tgenovese/hailfire-eagle/projects/ADC33/ADC33-parts.xls

NOM | DESCRIPTION | CODE FARNELL | QUANTITE
MICROCHIP MCP3008-I/SL | 10BIT ADC, 8 CH, SPI, SMD, SOIC16 | 1292241 | 1
TI REF2933AIDBZT | IC, SM, VOLT REF, 3.3V | 1459250 | 1
KEMET C0805C105K4RAC | CONDENSATEUR 0805 1UF 16V | 9227792 | 2
KEMET C0805C104K5RAC | CONDENSATEUR 100NF 50V X7R 0805 | 1414664 | 9
HARTING 0918 510 7323 | EMBASE HE10 COUDEE 10 VOIES | 1096980 | 1
AMP 5-825437-0 | BARRETTE COUDEE 1 RANGEE 50 VOIES 2.54MM | 3417931 | 1
IMO 21.155MH/3 | EMBASE COUDEE 3 VOIES | 9632905 | 1
IMO 21.1550M/3 | FICHE MALE LIBRE 3 VOIES | 9632743 | 1
