tgenovese/hailfire-eagle/projects/AlimBoard/AlimBoard-parts.xls

NOM | DESCRIPTION | CODE FARNELL | QUANTITE
TRACOPOWER TEN 20-2411WIN | CONVERTISSEUR DC/DC 20W 5V/4A | 1284266 | 1
TRACOPOWER TEN 15-2410WI | CONVERTISSEUR DC/DC 15W 3.3V/3A | 1007485 | 1
CAMDEN ELECTRONICS CTB9350/2A | EMBASE COUDEE 2 VOIES | 3882093 | 3
CAMDEN ELECTRONICS CTB9200/2A | BORNIER ENFICHABLE 2 VOIES | 3881854 | 3
IMO 21.155MH/3 | EMBASE COUDEE 3 VOIES | 9632905 | 3
IMO 21.1550M/3 | FICHE MALE LIBRE 3 VOIES | 9632743 | 3
