tgenovese/hailfire-eagle/projects/PWM50/PWM50-parts.xls

NOM | DESCRIPTION | CODE FARNELL | QUANTITE
AVAGO HCPL-0630-000E | OPTOCOUPLEUR CMS DOUBLE SORTIE LOGIQUE | 359993 | 4
KOA SG73S2ATTD2000F | RESISTANCE 200 OHM 1% 0805 | 1400301 | 8
KOA SG73S2ATTD3900F | RESISTANCE 390 OHM 1% 0805 | 1400309 | 8
KEMET C0805C104K5RAC | CONDENSATEUR 100NF 50V X7R 0805 | 1414664 | 12
HARTING 0918 510 7323 | EMBASE HE10 COUDEE 10 VOIES | 1096980 | 1
AMP 5-825437-0 | BARRETTE COUDEE 1 RANGEE 50 VOIES 2.54MM | 3417931 | 1
IMO 21.155MH/3 | EMBASE COUDEE 3 VOIES | 9632905 | 1
IMO 21.1550M/3 | FICHE MALE LIBRE 3 VOIES | 9632743 | 1
