tgenovese/hailfire-eagle/projects/MainStack/StackOverflow/StackOverflow-parts.xls

NOM | DESCRIPTION | CODE FARNELL | QUANTITE
AMP 5-826632-0 | BARRETTE DROITE 2 RANGEES 100V 2.54MM | 3418560 | 2
HARTING 0918 510 7324 | EMBASE HE10 DROITE 10 VOIES | 1096985 | 14
