tgenovese/hailfire-eagle/projects/MainStack/StackUnderflow/StackUnderflow-parts.xls

NOM | DESCRIPTION | CODE FARNELL | QUANTITE
HARWIN M20F6113205 | CONNECTEUR PC104 64 VOIES | 359993 | 2
AMP 5-825437-0 | BARRETTE COUDEE 1 RANGEE 50 VOIES 2.54MM | 3417931 | 1
AMP 5-826634-0 | BARRETTE COUDEE 2 RANGEES 100 VOIES 2.54MM | 3418650 | 1
IMO 21.155MH/3 | EMBASE COUDEE 3 VOIES | 9632905 | 1
IMO 21.1550M/3 | FICHE MALE LIBRE 3 VOIES | 9632743 | 1
KEMET C0805C105K4RAC | CONDENSATEUR 0805 1UF 16V | 9227792 | 2
KEMET C0805C104K5RAC | CONDENSATEUR 100NF 50V X7R 0805 | 1414664 | 4
MAXIM MAX3390 | LOGIC LEVEL CONVERTER | sample | 1
MAXIM MAX3391 | LOGIC LEVEL CONVERTER | sample | 1
KPS-1280 | SWITCH CMS COUDE | SparkFun: 8769
