tgenovese/hailfire-eagle/projects/Attic/SandwichBoard/SandwichBoard-parts.xls

NOM | DESCRIPTION | CODE FARNELL | QUANTITE
AMP 5-826632-0 | BARRETTE DROITE 2 RANGEES 100V 2.54MM | 3418560 | 2
AMP 5-825437-0 | BARRETTE COUDEE 1 RANGEE 50 VOIES 2.54MM | 3417931 | 1
HARWIN M20F6112005 | CONNECTEUR PC104 40 VOIES | 359970 | 1
KEMET C0805C105K4RAC | CONDENSATEUR 0805 1UF 16V | 9227792 | 3
KEMET C0805C104K5RAC | CONDENSATEUR 100NF 50V X7R 0805 | 1414664 | 6
MAXIM MAX3390 | LOGIC LEVEL CONVERTER | sample | 1
MAXIM MAX3391 | LOGIC LEVEL CONVERTER | sample | 2
