tgenovese/hailfire-eagle/projects/Dumb-E/Dumb-E.brd

## EAGLE design projects/Dumb-E/Dumb-E.brd (2016-03-28)

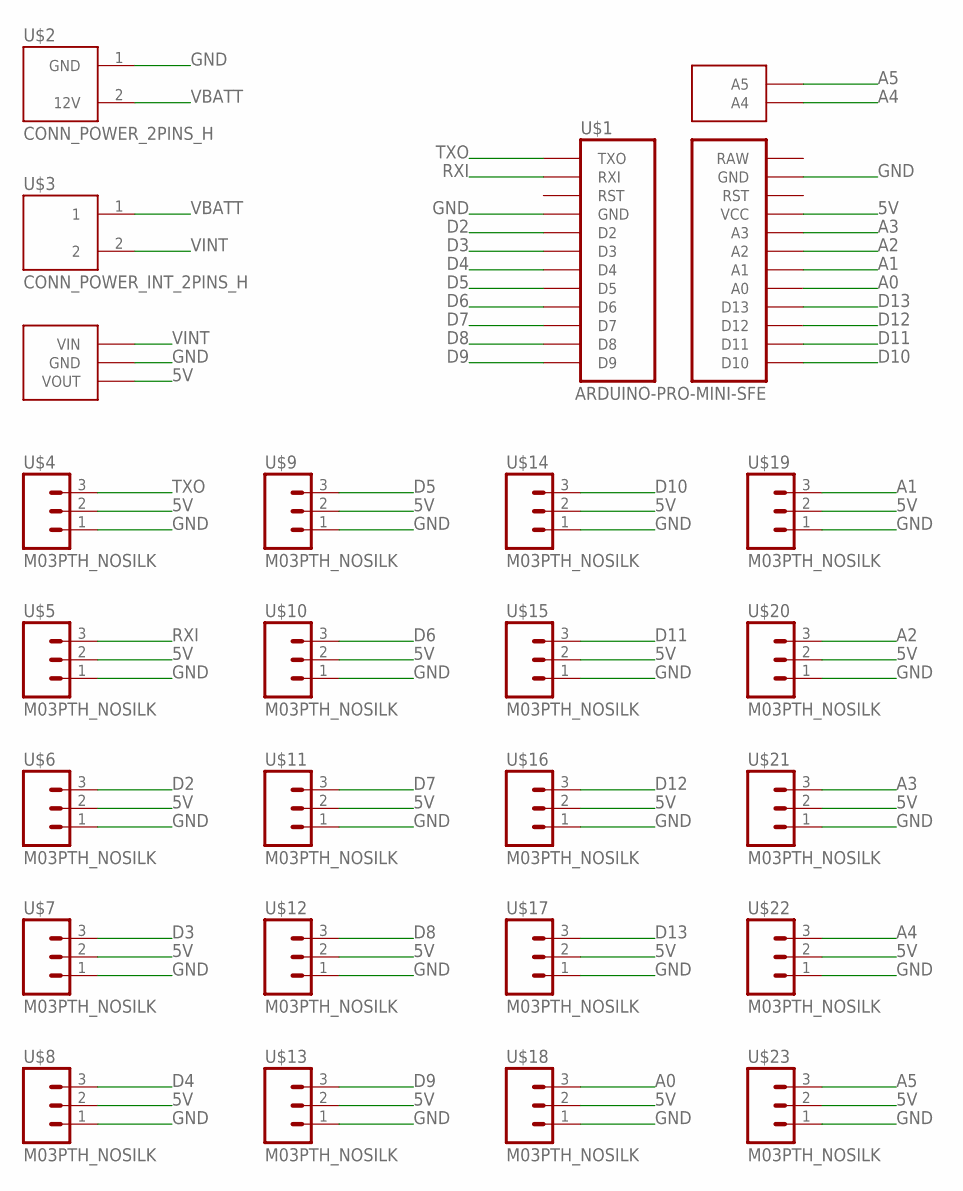
[picture p1: schematic Dumb-E.sch]

Parts:
U$1: ARDUINO-PRO-MINI-SFE; ARDUINO-PRO-MINI
U$2: CONN_POWER_2PINS_H; 2PINS_5MM_90DEG
U$3: CONN_POWER_INT_2PINS_H; 2PINS_5MM_90DEG
U$4, U$5, U$6, U$7, U$8, U$9, U$10, U$11, U$12, U$13, U$14, U$15, U$16, U$17, U$18, U$19, U$20, U$21, U$22, U$23: M03PTH_NOSILK; 1X03/NOSILK
U$25: DE-SW0XX

Connections:
5V: U$1.P$17 (VCC), U$4.2, U$5.2, U$6.2, U$7.2, U$8.2, U$9.2, U$10.2, U$11.2, U$12.2, U$13.2, U$14.2, U$15.2, U$16.2, U$17.2, U$18.2, U$19.2, U$20.2, U$21.2, U$22.2, U$23.2, U$25.VOUT
A0: U$1.P$9 (A0), U$18.3
A1: U$1.P$11 (A1), U$19.3
A2: U$1.P$13 (A2), U$20.3
A3: U$1.P$15 (A3), U$21.3
A4: U$1.P$26 (A4), U$22.3
A5: U$1.P$25 (A5), U$23.3
D2: U$1.P$16 (D2), U$6.3
D3: U$1.P$14 (D3), U$7.3
D4: U$1.P$12 (D4), U$8.3
D5: U$1.P$10 (D5), U$9.3
D6: U$1.P$8 (D6), U$10.3
D7: U$1.P$6 (D7), U$11.3
D8: U$1.P$4 (D8), U$12.3
D9: U$1.P$2 (D9), U$13.3
D10: U$1.P$1 (D10), U$14.3
D11: U$1.P$3 (D11), U$15.3
D12: U$1.P$5 (D12), U$16.3
D13: U$1.P$7 (D13), U$17.3
GND: U$1.P$18 (GND), U$1.P$21 (GND), U$2.1 (GND), U$4.1, U$5.1, U$6.1, U$7.1, U$8.1, U$9.1, U$10.1, U$11.1, U$12.1, U$13.1, U$14.1, U$15.1, U$16.1, U$17.1, U$18.1, U$19.1, U$20.1, U$21.1, U$22.1, U$23.1, U$25.GND
RXI: U$1.P$22 (RXI), U$5.3
TXO: U$1.P$24 (TXO), U$4.3
VBATT: U$2.2 (12V), U$3.1
VINT: U$3.2, U$25.VIN

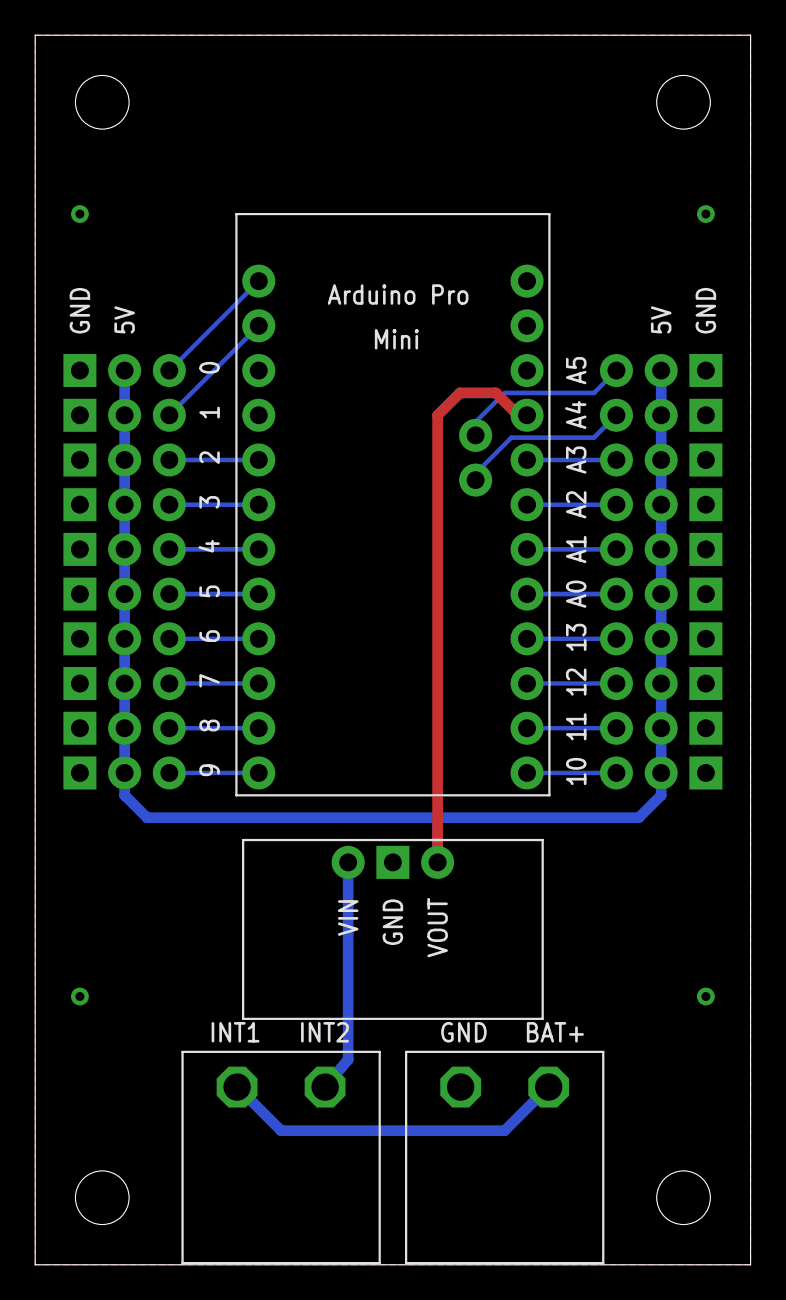
[picture p2: board Dumb-E.brd from above]

Board: 2 copper layers, 40.6 x 69.8 mm, 24 parts (0 on the bottom side), 24 nets.
