tgenovese/hailfire-eagle/(commit log)

2016-03-28 Add the CarrierBoard EAGLE project. This board carries and powers the FPGA/Gumstix stack and the extension cards.
2016-03-28 Add the SandwichBoard EAGLE project. This board connects the Summit/Overo stack to the Quicgate FPGA via an SPI interface. It also breakouts serial ports, I2C, PWM and ADC pins from the Overo. The di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
2016-03-28 Add the AlimBoard EAGLE project. This board carries the TRACO DC/DC converter and provides 3.3V and 5V to the robot's systems.
2016-03-28 Add a personal library with the following symbols: - Carstac symbols: CARDSTAC_FULL_STD_ROWS_AB and CARDSTAC_FULL_STD_ROWS_GH - Gumstix symbols: SUMMIT_EXPANSION_CONN_SV1 - Power connectors symbols: 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
    The library also contains the following packages:
    - 2X32 (header, 0.1" spaced)
    - 2X20 (header, 0.1" spaced)
    - 2PINS_5MM_90DEG and 3PINS_3.81MM_90DEG (power connectors)
    The symbols and the packages are associated in devices for ready use in PCB projects.
2016-03-28 Corrected the CARDSTAC_FULL_STD_ROWS_GH device (wrong pin numbering).
2016-03-28 Add the schematic and the board in the CarrierBoard project. The board should be ok (everything is routed, the silkscreen is done, and the mounting holes are there).
    [CarrierBoard.brd, CarrierBoard.sch]
2016-03-28 Add: - symbol, footprint and device for the TRACO TEN 40-1220 DC/DC converter - symbol and device for an interrupter connector (for the AlimBoard).
2016-03-28 Add the schematic and the board in the AlimBoard project. The board should be ok (everything is routed, the silkscreen is done, and the mounting holes are there). The board features: - 2 2-pin batter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
    [AlimBoard.brd, AlimBoard.sch]
2016-03-28 Add the symbols, footprints and devices for the MAX3373E, MAX3378E, MAX3390E to MAX3393E low voltage level translators.
2016-03-28 Add the symbols, footprints and devices for 1x3, 1x4 and 2x5 headers in vertical or 90deg mounts.
2016-03-28 Changed the orientation of 90deg silkscreen so that it will be easier to know where pin 1 is once the header is soldered (always leftmost when looking at the header, and on the bottom row if there ar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
2016-03-28 Add 0805 SMD capacitor.
2016-03-28 Various modifications: - changed the 2X20 header to include the Summit expansion board outline, renamed the symbol, package and device to GUMSTIX_SUMMIT_SV1 - added a jumper symbol and solder jumper 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
2016-03-28 Add the schematic and the board in the SandwichBoard project. The board should be ok (everything is routed, the silkscreen is done, and the mounting holes are there).
    [SandwichBoard.brd, SandwichBoard.sch]
2016-03-28 Add the footprint, symbol and device for the Gumstix Overo COMs. Those were extracted from the Summit schematic (PCB30001-R2185).
2016-03-28 Modified the Gumstix Overo footprint because of BatchPCB's 8mil limit.
2016-03-28 New EAGLE project: QuicOvero. This board serves the same purpose than the SandwichBoard, but without the Summit expansion board. The Gumstix Overo is directly connected on the QuicOvero, which itself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
    [QuicOvero.brd, QuicOvero.sch]
2016-03-28 Add Microchip's MCP3008 A/D converter, shrouded 2x05 connectors (horizontal and right-angled) and TI's REF2933 3.3V voltage reference.
2016-03-28 Add the ADC33 Eagle project. This is an ADC board for the robot, carrying an MCP3008. The board is 2"x3" and should be complete.
    [ADC33.brd, ADC33.sch]
2016-03-28 Add HCPL-0630 and 0805 resistor parts.
2016-03-28 Add the PWM50 Eagle project. This is a PWM board for the robot, carrying four HCPL-0630. The board is 2"x3" and should be complete.
    [PWM50.brd, PWM50.sch]
2016-03-28 Minor fixes in ADC33 and PWM50 boards.
    [ADC33.brd, ADC33.sch, PWM50.brd, PWM50.sch]
2016-03-28 Small fixes to AlimBoard.
    [AlimBoard.brd, AlimBoard.sch]
2016-03-28 Add TRACO TEN 15-2410WI (3.3V) and TEN 20-2411WIN (5V).
2016-03-28 Some adjustements: * CarrierBoard is now 3.4"x3" * AlimBoard, PWM50 and ADC33 are now 3.4"x2.1" * Moved the power connectors to the right of the AlimBoard, PWM50 and ADC33, away from the logic connec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
    [ADC33.brd, ADC33.sch, AlimBoard.brd, AlimBoard.sch, CarrierBoard.brd, CarrierBoard.sch, PWM50.brd, SandwichBoard.brd]
2016-03-28 Add parts lists.
    [ADC33-parts.xls, AlimBoard-parts.xls, CarrierBoard-parts.xls, PWM50-parts.xls, SandwichBoard-parts.xls]
2016-03-28 Put power traces on the bottom layer (soldering side).
    [AlimBoard.brd]
2016-03-28 Add gerber files archives sent for manufacturing to BatchPCB
2016-03-28 Add 5-pin 0.1" header
2016-03-28 Add CoreExpansion board (WIP). This board plugs in one of the expansion connectors of the CarrierBoard and hosts connectors for cards and devices common to every robot (motor controller, quadrature e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
    [CoreExpansion.brd, CoreExpansion.sch]
2016-03-28 Progress on CoreExpansion board (should be finished). The level shifters for quadrature encoders were moved to another board.
    [CoreExpansion.brd, CoreExpansion.sch]
2016-03-28 Add QuadEnc50 board, designed to provide logic level conversion from 5.0V to 3.3V to interface 4 quadrature encoders using 5.0V logic level to an FPGA using 3.3V IO.
    [QuadEnc50.brd, QuadEnc50.sch]
2016-03-28 Add Gumstix Pinto footprint. To be checked against Gumstix's schematic when Pinto is released.
2016-03-28 Add projects for smaller and simpler main stack (Gumstix Overo COM + Gumstix Pinto Expansion Board + QuicGate FPGA).
2016-03-28 Copy CoreExpansion schematics for the StackOverflow board.
    [StackOverflow.brd, StackOverflow.sch]
2016-03-28 Copy SandwichBoard schematics for the StackUnderflow board.
    [StackUnderflow.brd, StackUnderflow.sch]
2016-03-28 StackOverflow WiP
    [StackOverflow.brd, StackOverflow.sch]
2016-03-28 StackUnderflow WiP
    [StackUnderflow.brd, StackUnderflow.sch]
2016-03-28 Move some projects to the Attic: * CarrierBoard: provided power to the FPGA/Gumstix stack and carried 2*64pin expansion connectors * SandwichBoard: plugged on top of the FPGA and provided a connector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
    Those projects are replaced by:
    * CarrierBoard and SandwichBoard/QuicOvero replaced by StackUnderflow (which carries the FPGA and a Pinto/Overo stack)
    * CoreExpansion: replaced by StackOverflow (which plugs on top of the FPGA and carries 14 HE10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
    [CarrierBoard-parts.xls, CarrierBoard.brd, CarrierBoard.sch, CoreExpansion.brd, CoreExpansion.sch, QuicOvero.brd, QuicOvero.sch, SandwichBoard-parts.xls]
2016-03-28 Import the Pinto-TH expansion board schematics for reference.
    Those schematics originate at pubs.gumstix.com and are made available by Gumstix, Inc under a Creative Commons Attribution-ShareAlike2.5 License.
    [PCB30011-R2519.brd, PCB30011-R2519.sch]
2016-03-28 Rename Gumstix Pinto symbol, footprint and device to GUMSTIX_PINTO_60PIN
2016-03-28 Add a 40-pin version of the Gumstix Pinto (without the extra GPIOs and MMC signals), easier to place on a board.
2016-03-28 Modify the StackUnderflow board to take into account the corrected Gumstix Pinto (WiP)[C
    [StackUnderflow.brd, StackUnderflow.sch]
2016-03-28 Add a switch to enable/disable spi level converter three-state output.
    [StackUnderflow.brd, StackUnderflow.sch]
2016-03-28 Finish StackUnderflow board.
    [StackUnderflow.brd, StackUnderflow.sch]
2016-03-28 Finish StackOverflow board.
    [StackOverflow.brd, StackOverflow.sch]
2016-03-28 Changes on StackOverflow: * Swap ADCX_CS and ADCX_MOSI pins so as to have the CS signal on the pin affected by the pullup present on the Quicgate board. * Connect unused pins on ADC connectors and GP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
    [StackOverflow.brd, StackOverflow.sch]
2016-03-28 Changes on StackOverflow: * renamed EXTXX signals to EXT[1:4]_[0:7] signals. * removed a current loop on 3.3V power line
    [StackOverflow.brd, StackOverflow.sch]
2016-03-28 Modify StackOverflow to de-specialized most connectors. The board now provides: * 7 8-lines expansion connectors, * 1 ADC33 connector, * 1 PWM50 connector, * 1 QuadEnc connector, * 4 motor controller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
    [StackOverflow.brd, StackOverflow.sch]
2016-03-28 StackOverflow: change some of the layout
    [StackOverflow.brd, StackOverflow.sch]
2016-03-28 Add FPGA pin assignment list to match Quicgate pins with FPGA pins and MainStack pins.
    [FPGA-Pins-Assignments.xls]
2016-03-28 Add Arduino Pro Mini outline.
2016-03-28 Fix Arduino-Pro-Mini part.
2016-03-28 Set version on silkscreens. Add Gerber files for boards submitted to BatchPCB DRC bot. Del executable property on parts lists.
    [QuadEnc50-parts.xls, QuadEnc50.brd, StackOverflow-parts.xls, StackOverflow.brd, StackUnderflow-parts.xls, StackUnderflow.brd]
2016-03-28 Add EAGLE projects for two related boards: * JoystickBreakout: breaks out the two axis and the select line of the SparkFun thumb joystick * ThumbLCDBase: supports a serial-enabled SparkFun LCD, a Joy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
    [JoystickBreakout.brd, JoystickBreakout.sch, ThumbLCDBase.brd, ThumbLCDBase.sch]
2016-03-28 Change drills to 2mm. Connect LCD to digital pin 4 instead of hardware TX to program the Arduino in situ.
    [JoystickBreakout.brd, JoystickBreakout.sch, ThumbLCDBase.brd, ThumbLCDBase.sch]
2016-03-28 Set version on silkscreens. Add Gerber files for boards submitted to BatchPCB DRC bot.
    [JoystickBreakout.brd, ThumbLCDBase.brd]
2016-03-28 Change QuadEnc50 board to add pull-ups for channels A, B and index. Change encoder connectors to match HEDS5540 pinout.
    [QuadEnc50.brd, QuadEnc50.sch]
2016-03-28 Add the EAGLE project for the robot's RoboClaw Add-on board. This board converts the UART and encoders 0.1" headers to separate connector sockets.
    [RoboClawAddOn.brd, RoboClawAddOn.sch]
2016-03-28 Add silkscreen-less M03, M04 and M05 variants.
2016-03-28 Fix pin layout of encoder connectors.
    [RoboClawAddOn.brd, RoboClawAddOn.sch]
2016-03-28 Add Gerber files for board submitted to BatchPCB DRC bot.
2016-03-28 Add EAGLE files for Dumb-E baseboard for Arduino Pro Mini. Dumb-E.brd uploaded to board house oshpark.com.
    [Dumb-E.brd, Dumb-E.sch]
